S-March/stepNsnackFannyPack_Public/README.md

# smarchFanny

smarchSettlers

On average a person burns 1 calorie every 25 steps they take. One M&M is 4 calories...

I made a fanny pack that counts your steps and dispenses 1 M&M every 100 steps you take!
