S-March/stepNsnackFannyPack_Public/CAD/topCover.step

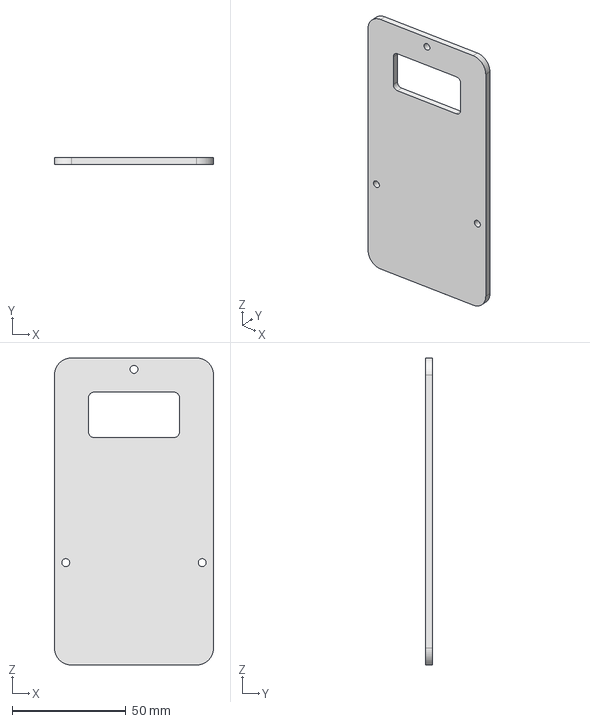
[picture p1: CAD file, 2021-07-22]
CAD/topCover.step
70.0 x 3.17 x 135.0 mm
