S-March/stepNsnackFannyPack_Public/CAD/augerSkinny.step

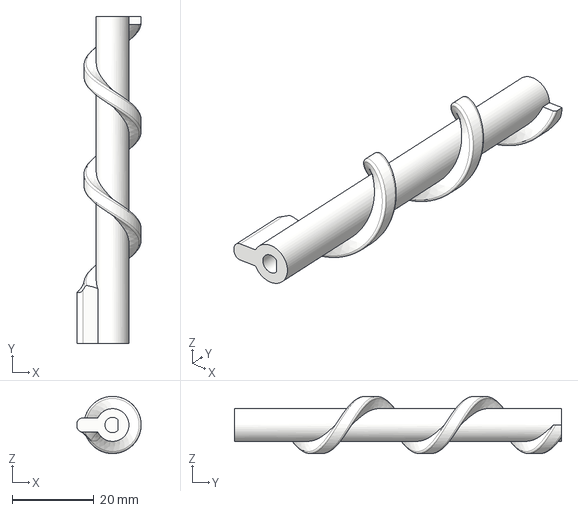
[picture p2: CAD file, 2021-07-22]
CAD/augerSkinny.step
15.7 x 80.0 x 14.0 mm
