S-March/stepNsnackFannyPack_Public/CAD/hopperRampWall.step

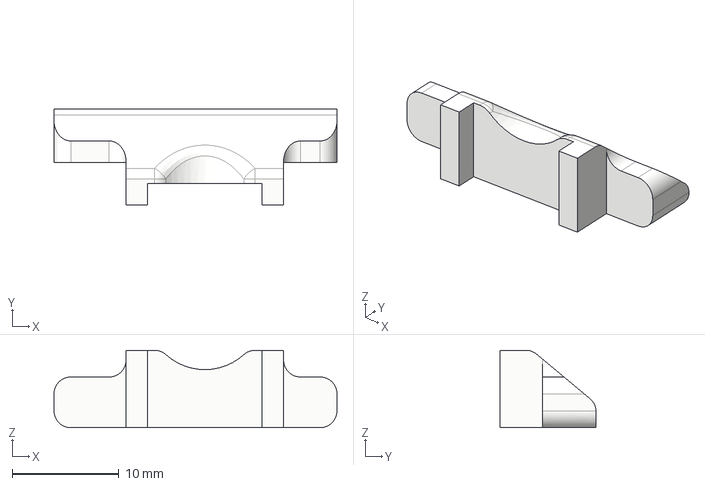
[picture p3: CAD file, 2021-07-22]
CAD/hopperRampWall.step
26.5 x 9.00 x 7.25 mm
