S-March/stepNsnackFannyPack_Public/CAD/motorBatSlab.step

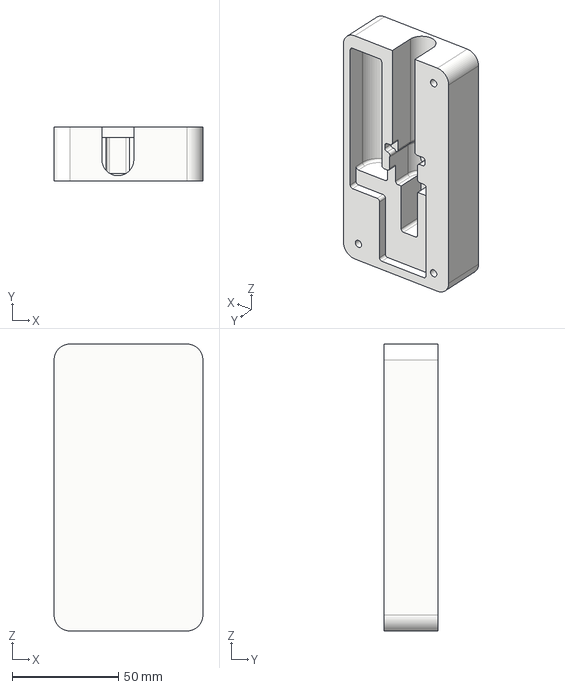
[picture p4: CAD file, 2021-07-22]
CAD/motorBatSlab.step
70.0 x 25.4 x 135.0 mm
