S-March/stepNsnackFannyPack_Public/CAD/hopperSlab.step

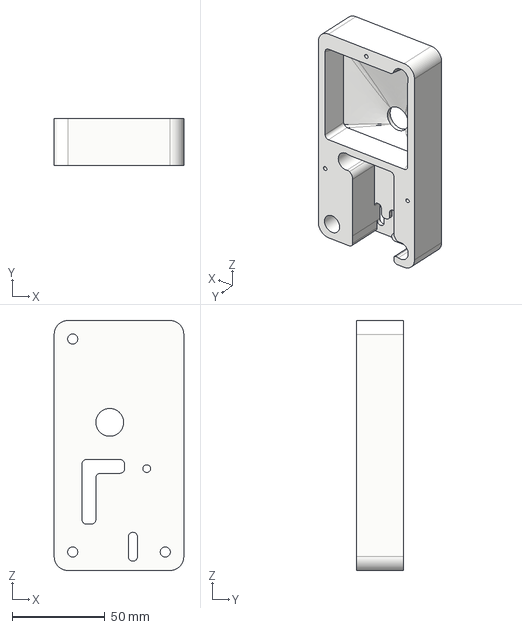
[picture p5: CAD file, 2021-07-22]
CAD/hopperSlab.step
70.0 x 25.4 x 135.0 mm
