S-March/stepNsnackFannyPack_Public/(list of files, cad)

Other CAD files:
CAD/augerSkinny.stl
CAD/hopperRampWall.stl
