S-March/stepNsnackFannyPack_Public/Hardware/notSoFitFanny/JLCPCB/notSoFitFanny.PDF

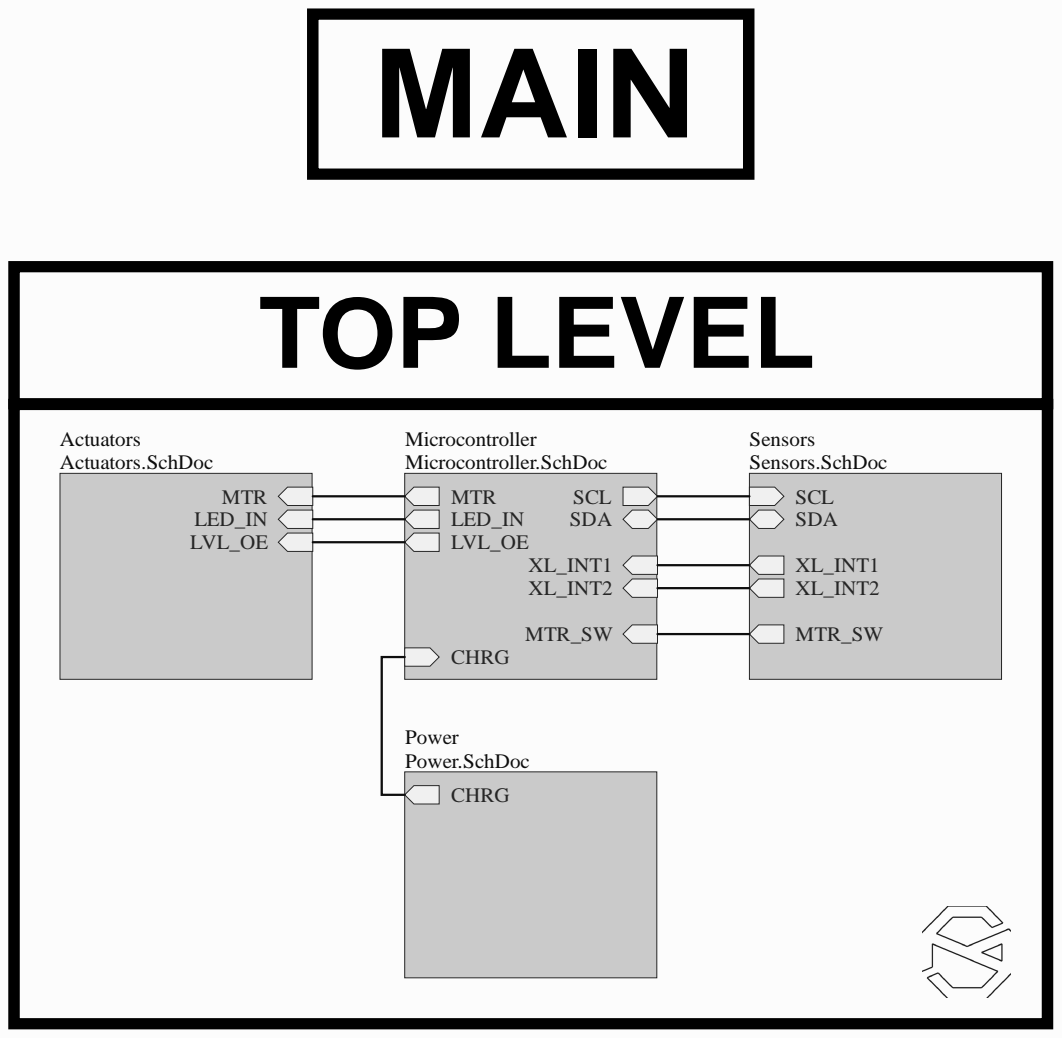
[picture p6: page 1]
TOP LEVEL

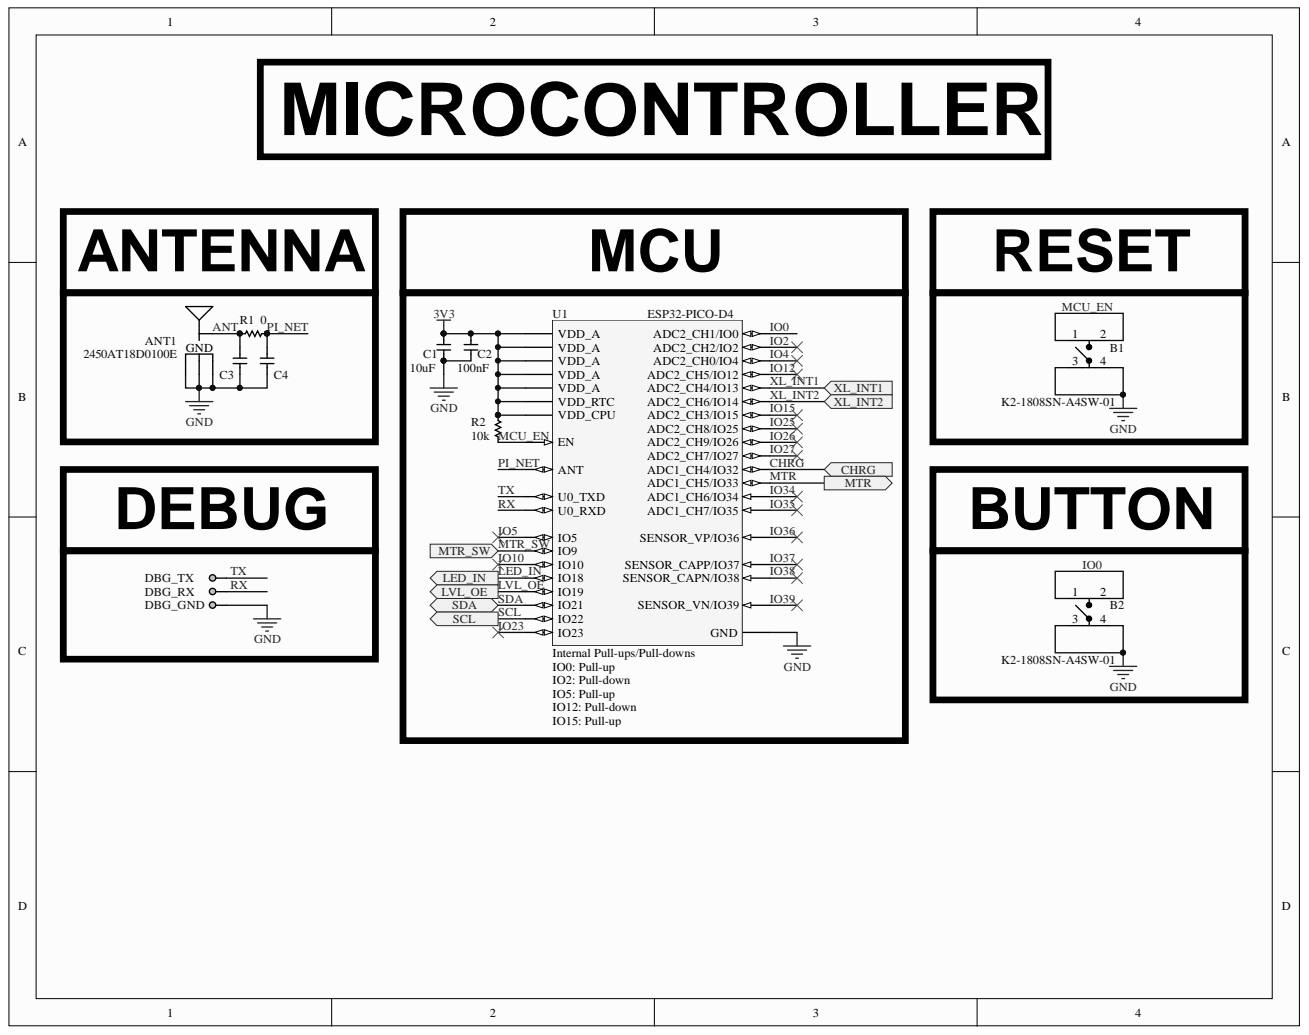
[picture p7: page 2]
DC2_CH3/IO15 ADC2_CH2/IO2 ADC2_CH1/IO0 ADC2_CH0/IO4; IO23 VDD_CP; IO21 VDD_A VDD_A; RESET MCU_EN; CHRG MTR

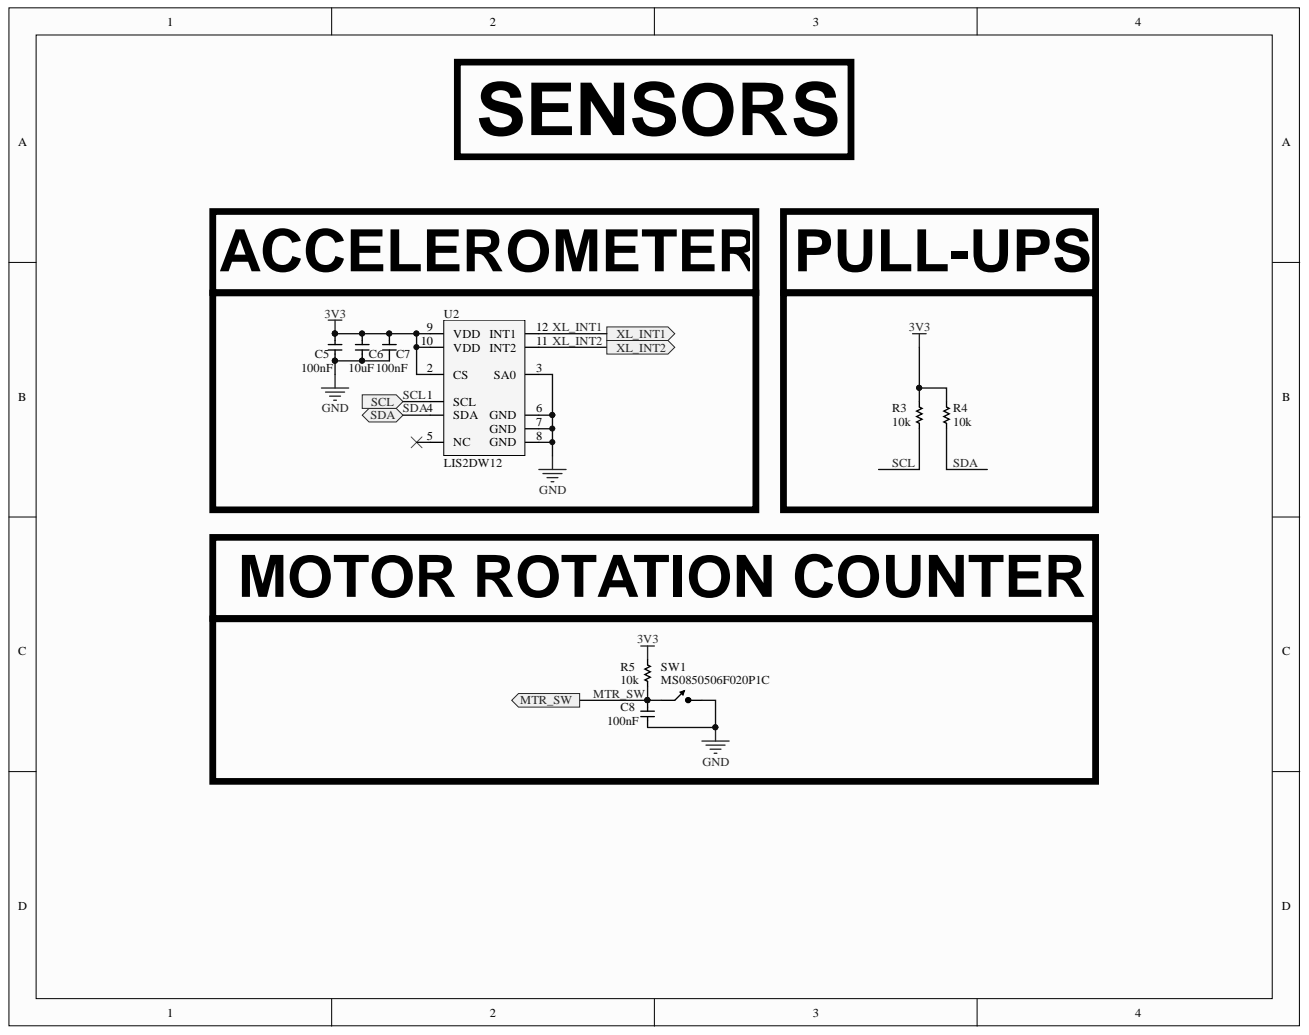
[picture p8: page 3]

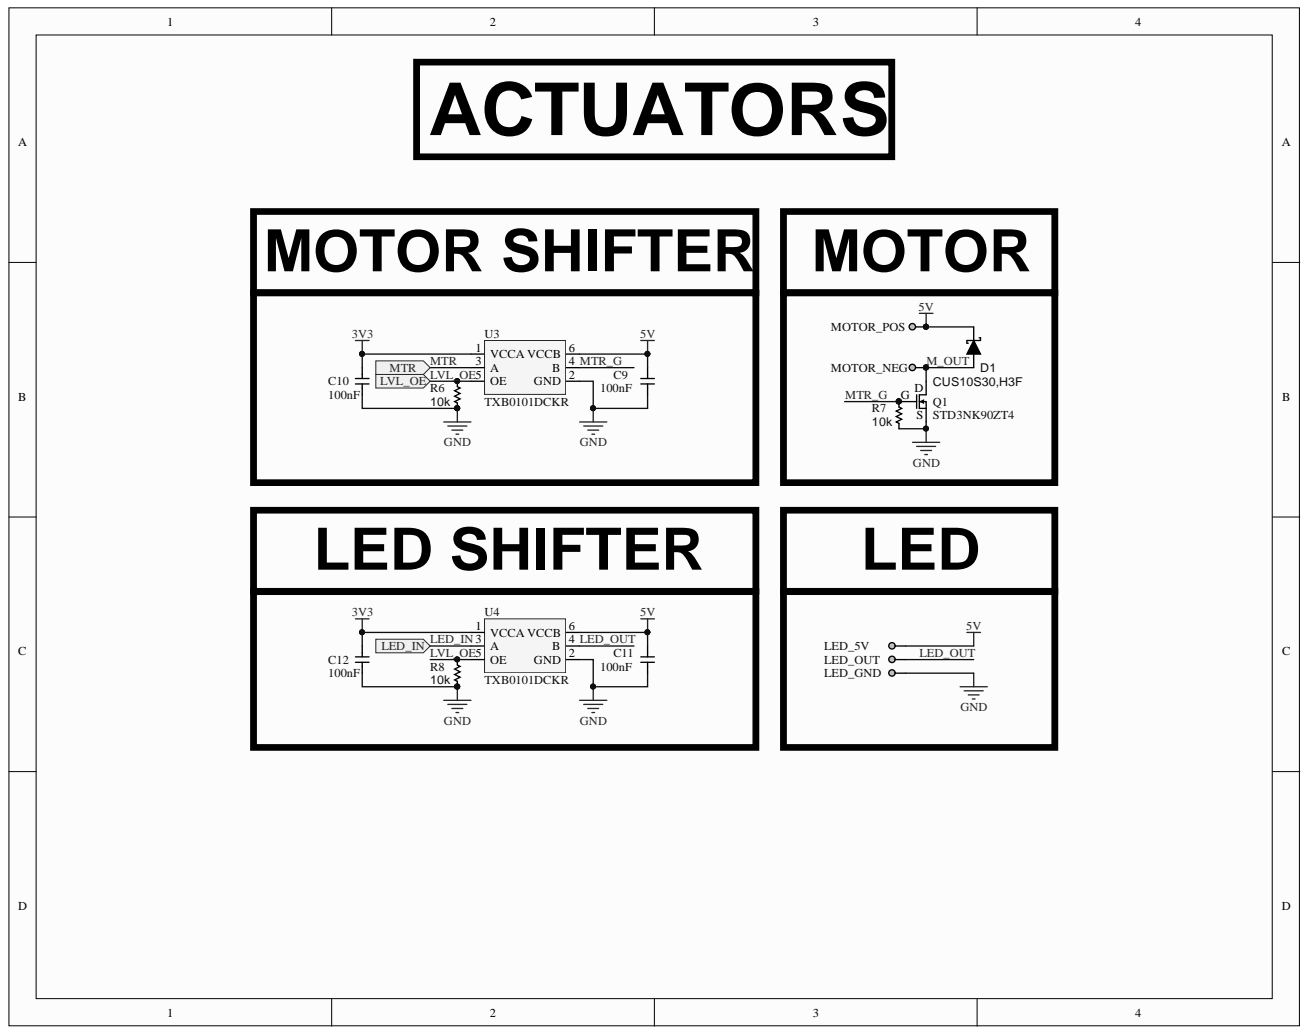
[picture p9: page 4]

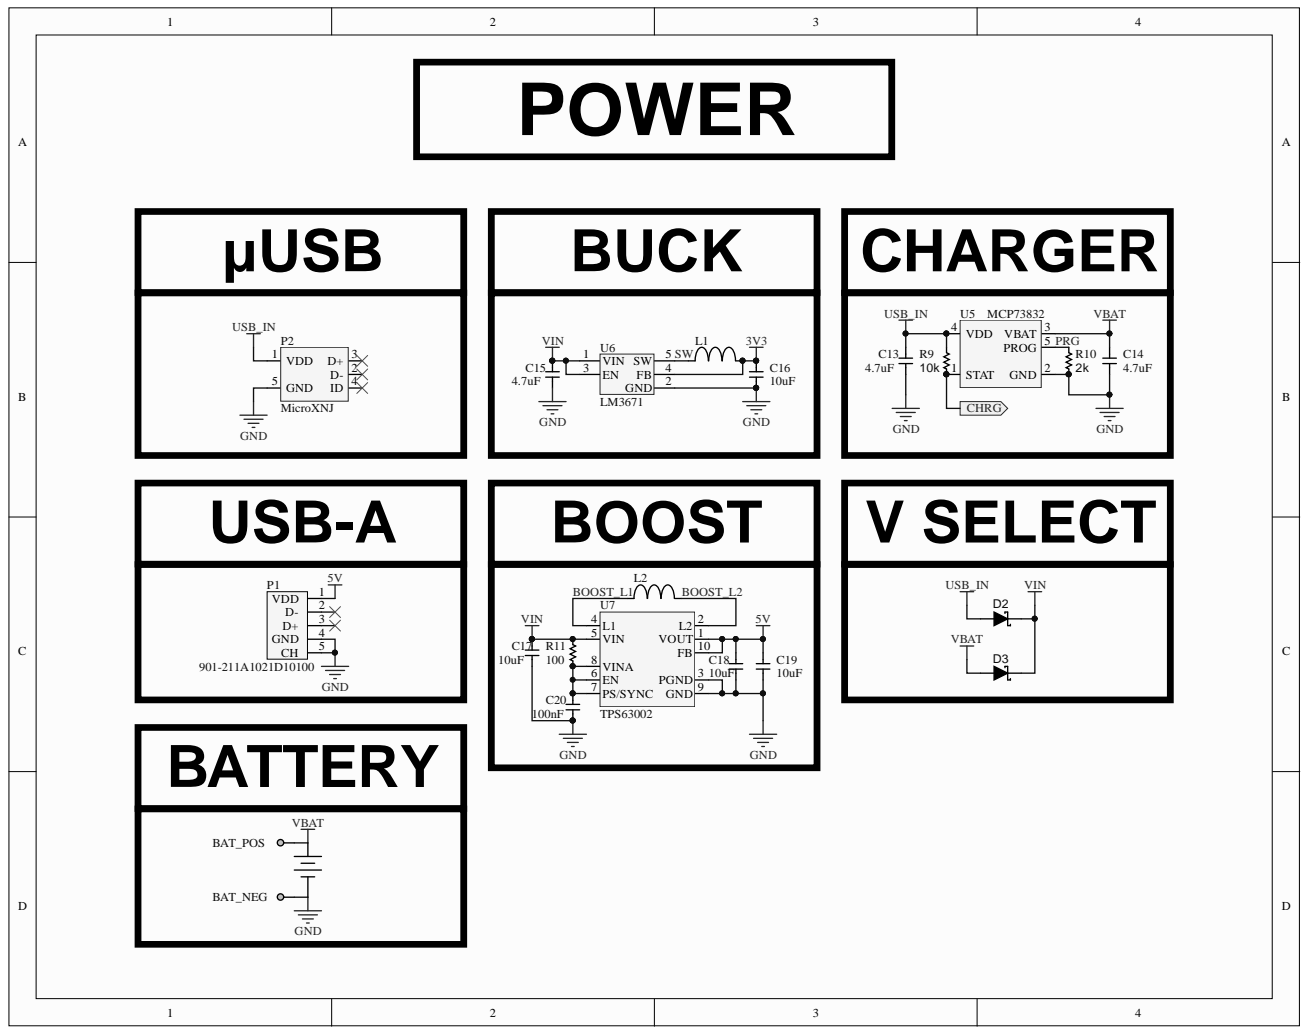
[picture p10: page 5]

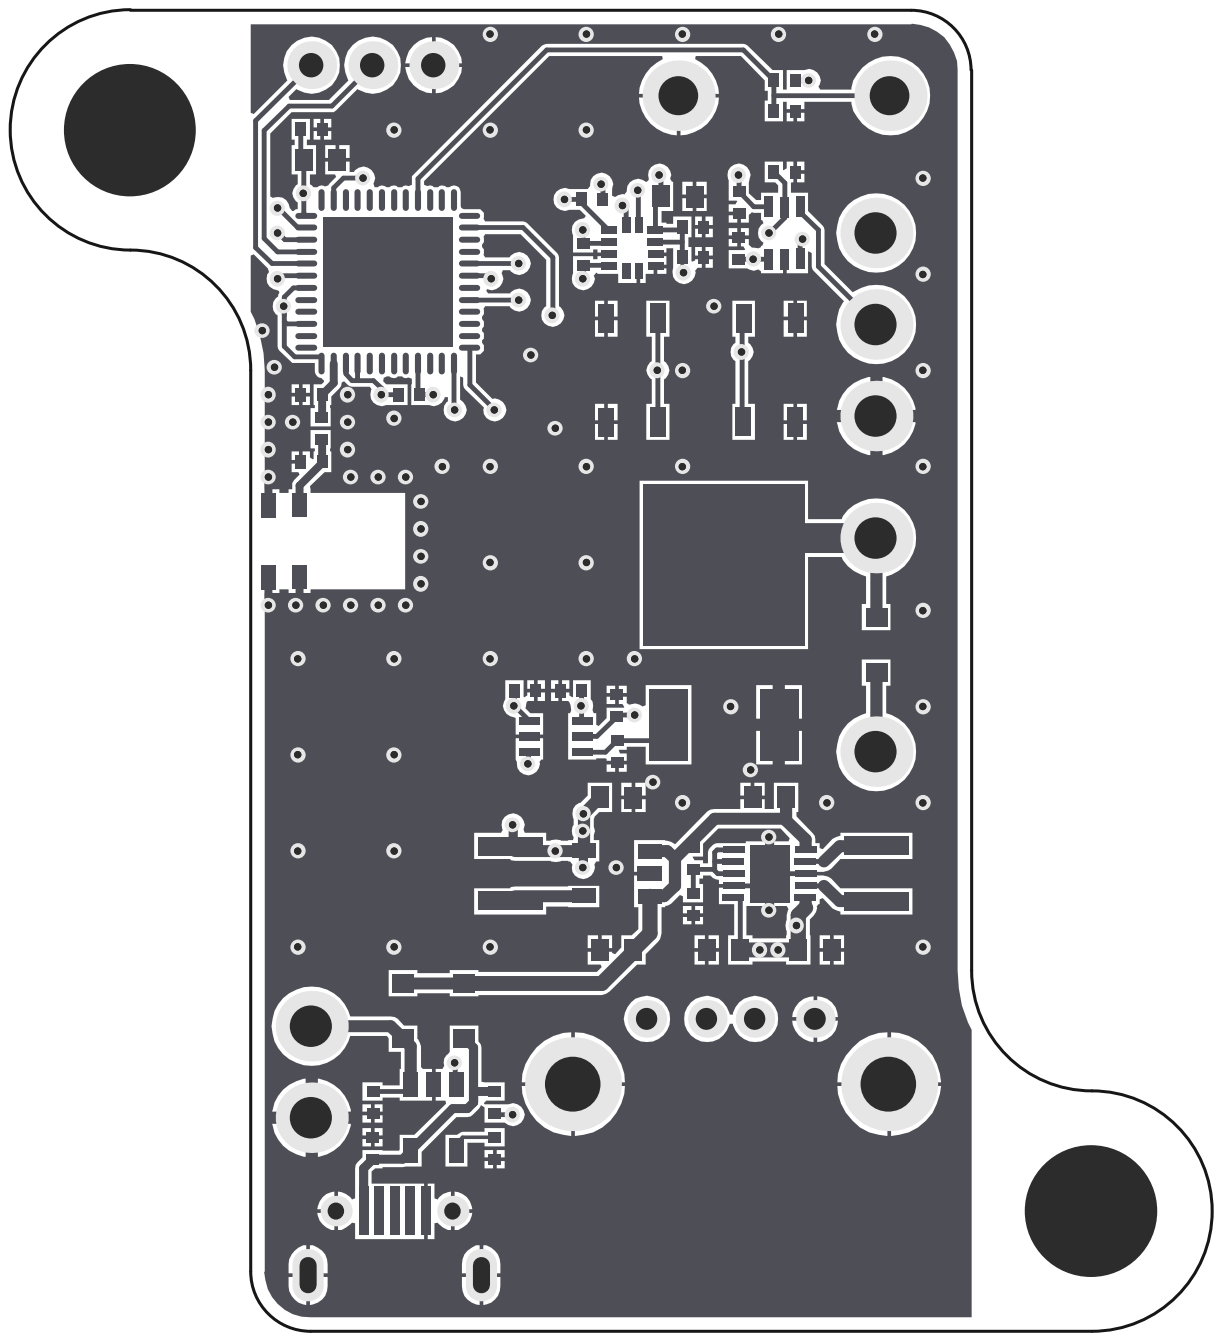
[picture p11: page 6]

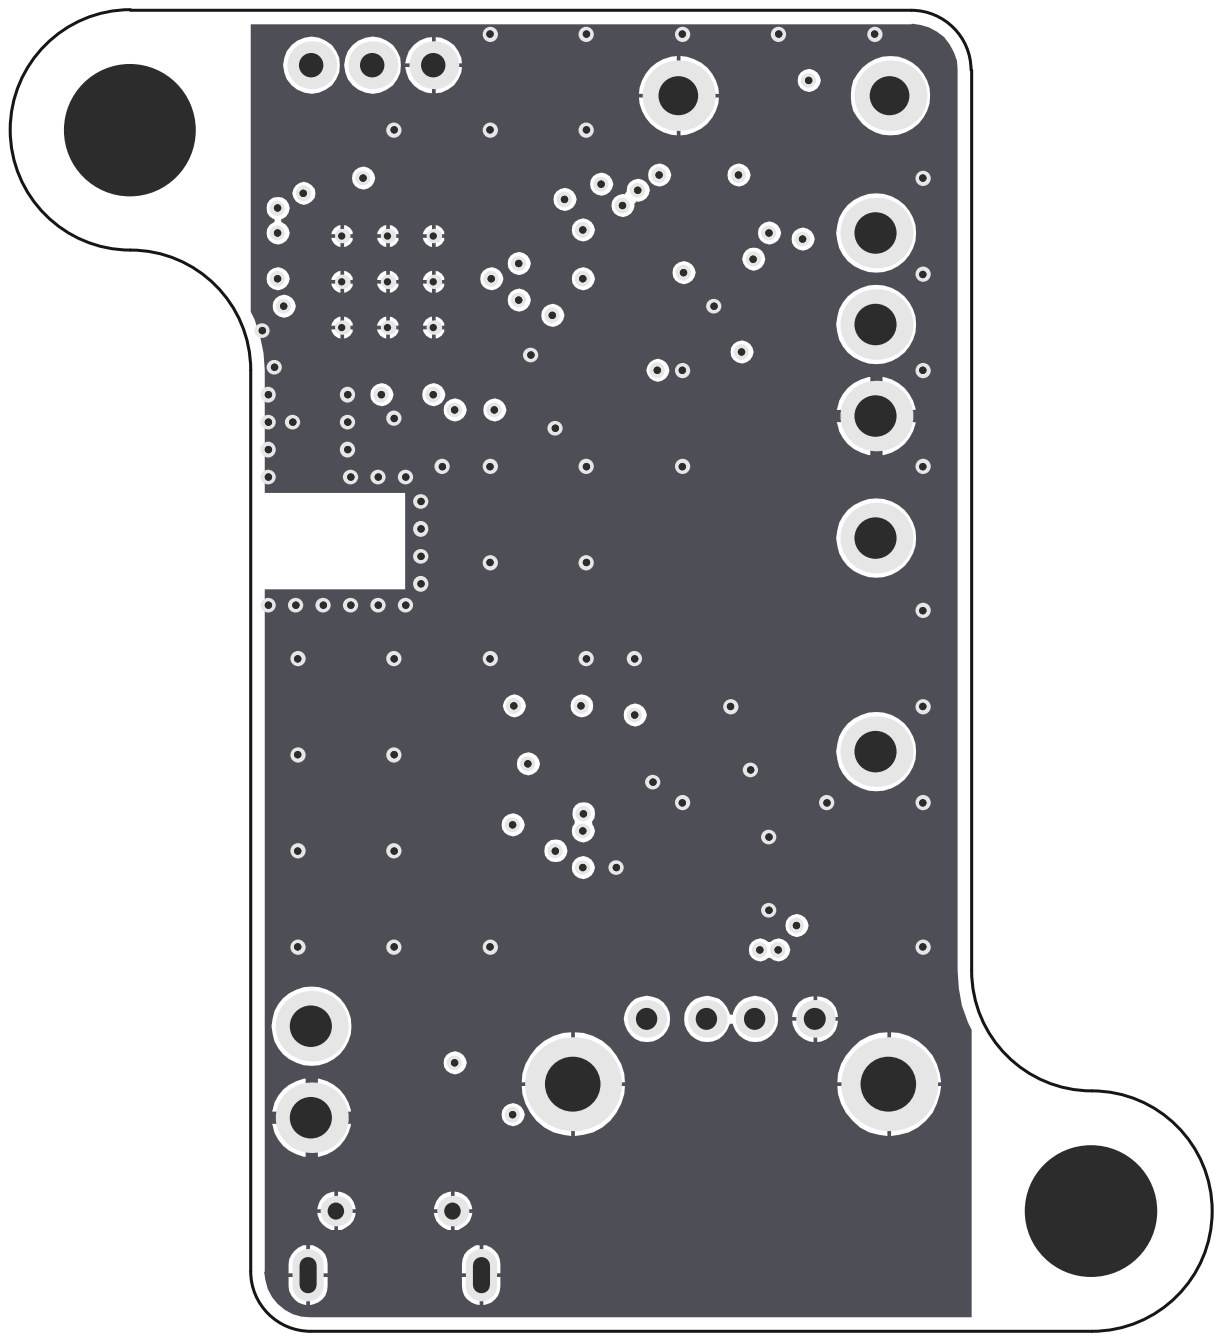
[picture p12: page 7]

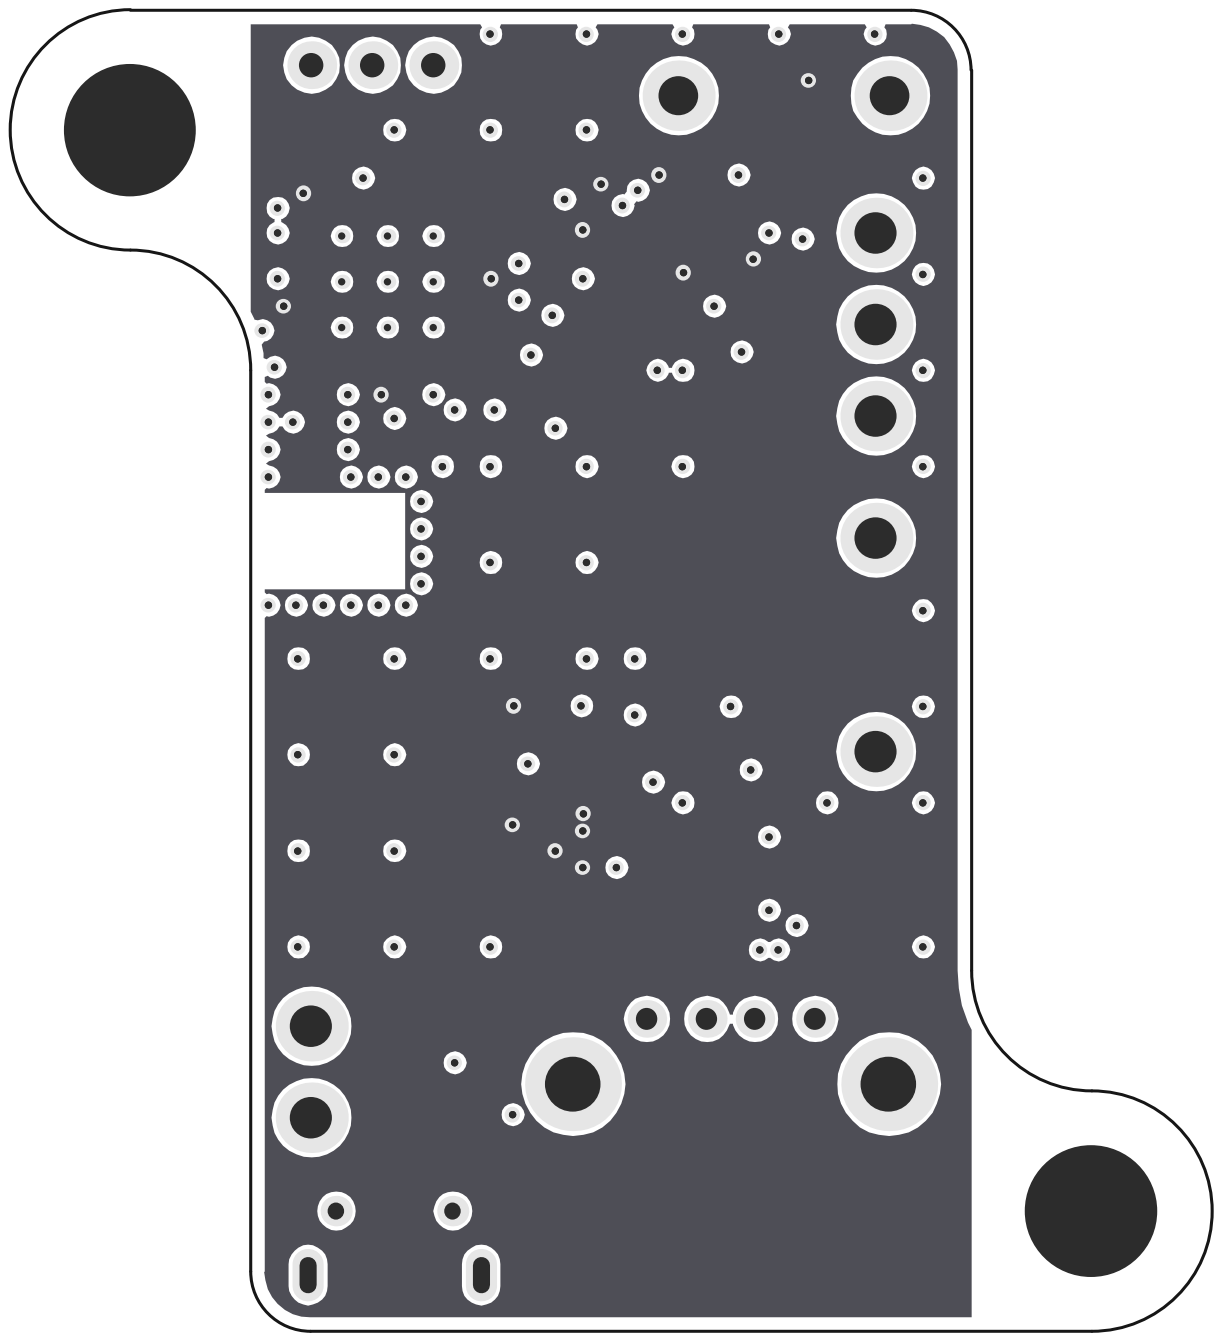
[picture p13: page 8]

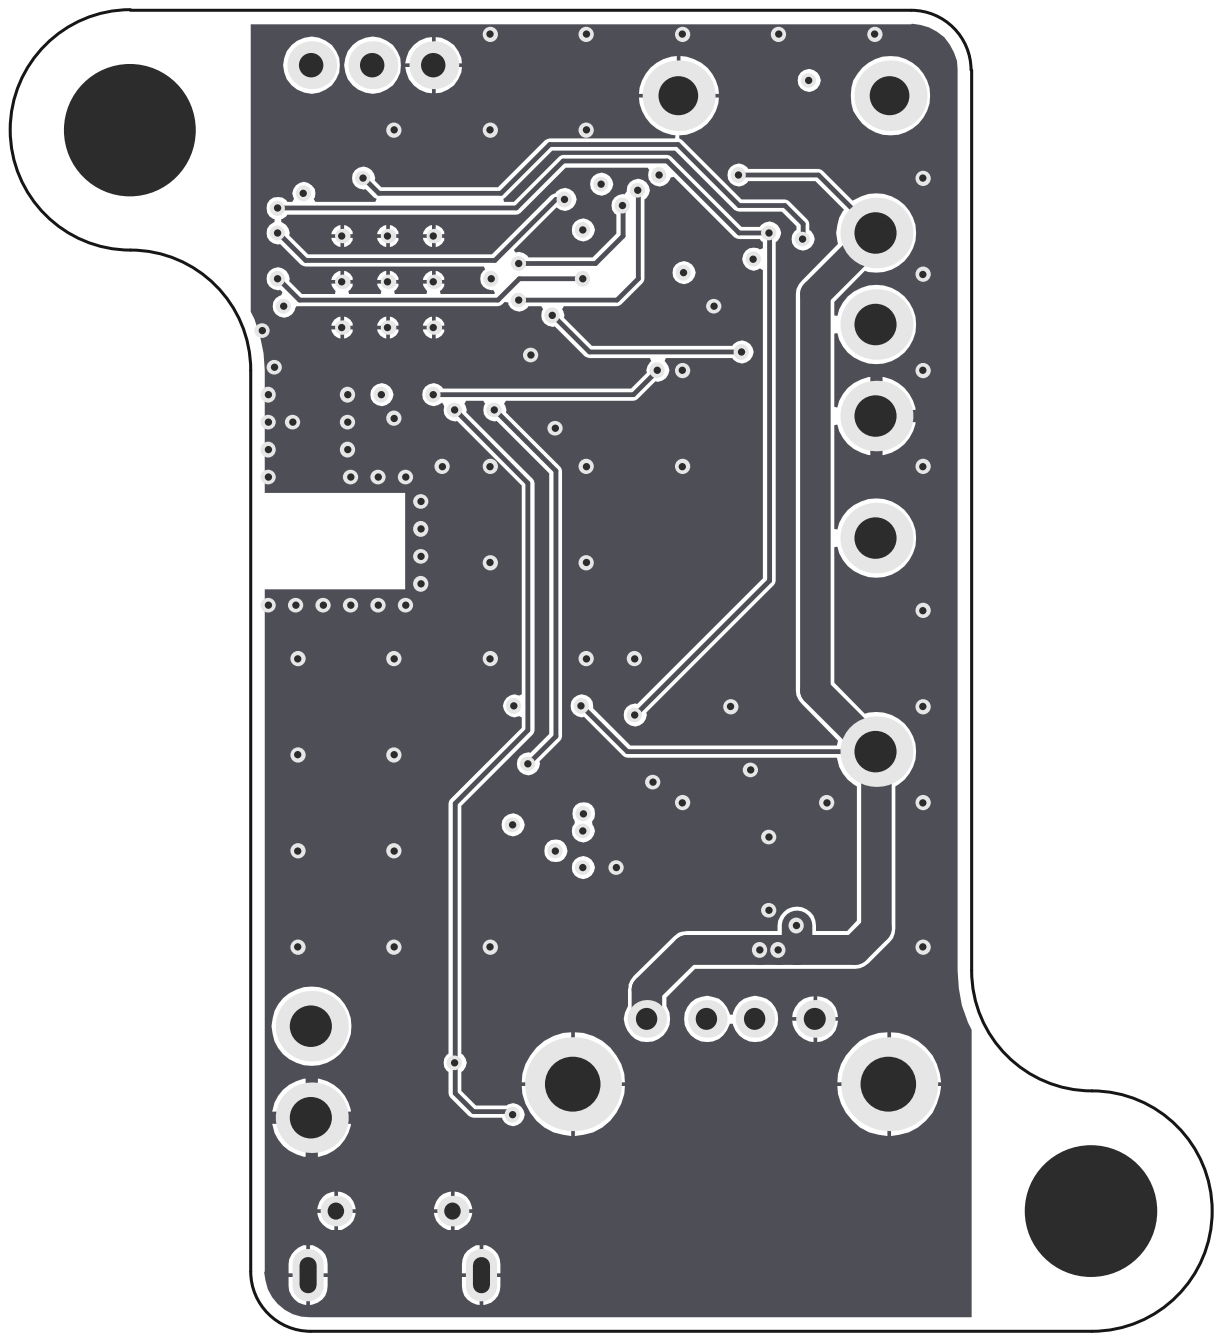
[picture p14: page 9]
