S-March/stepNsnackFannyPack_Public/(list of files, drawings)

Other design files:
Hardware/notSoFitFanny/Actuators.SchDoc
Hardware/notSoFitFanny/Main.SchDoc
Hardware/notSoFitFanny/Microcontroller.SchDoc
Hardware/notSoFitFanny/notSoFitFanny.PrjPcb
Hardware/notSoFitFanny/Power.SchDoc
Hardware/notSoFitFanny/Sensors.SchDoc
